johnMamish/milliLearn-boards/README.md

# milliLearn-boards
Dev boards targeting low-power machine learning
