johnMamish/milliLearn-boards/ice40/milliLearn-ice40/milliLearn-ice40.brd

## EAGLE design ice40/milliLearn-ice40/milliLearn-ice40.brd (2020-08-04)

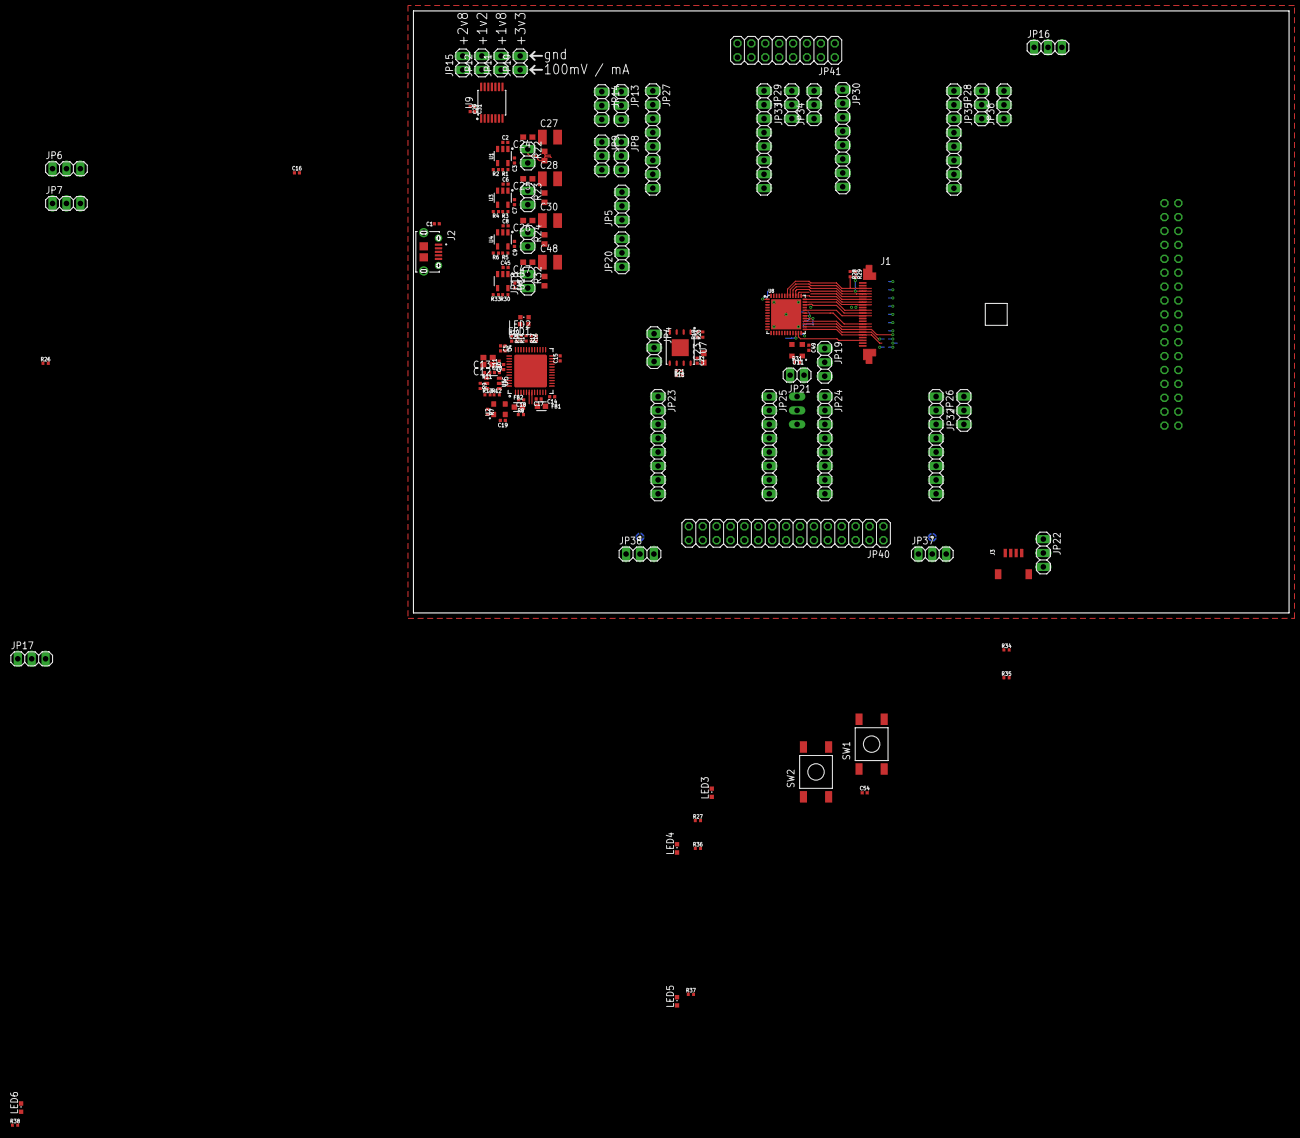
[picture p7: board milliLearn-ice40.brd from above]

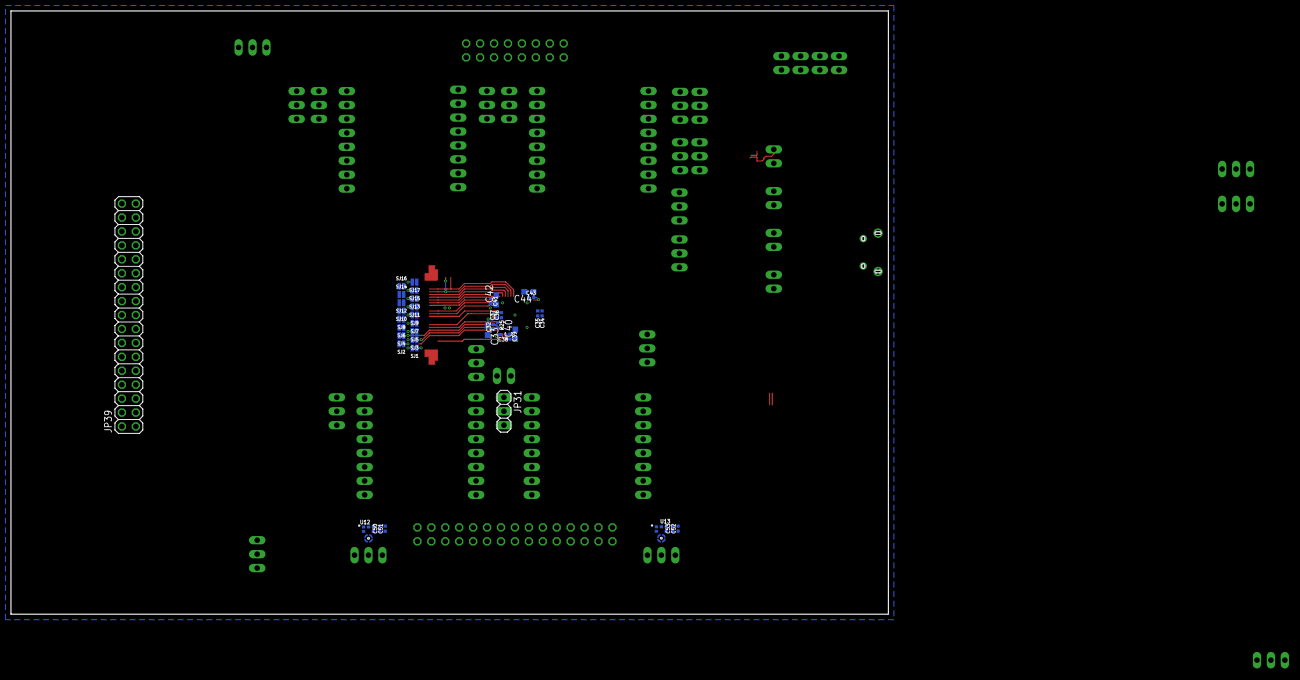
[picture p8: board milliLearn-ice40.brd from below]

Board: 4 copper layers, 160.0 x 110.0 mm, 176 parts (39 on the bottom side), 124 nets.

Parts:
C1: C0402_COMPACT
C2, C3, C6, C7, C8, C9, C29, C34, C36, C45, C46: 1u; C0402_COMPACT
C4, C5, C10, C11, C14, C15, C16, C17, C18, C19, C20, C22, C31, C32, C35, C37, C38, C39, C41, C43, C49, C50, C52, C54: 100n; C0402_COMPACT
C12, C13, C23, C24, C25, C26, C33, C40, C42, C44, C47: 4.7u; C0603
C21: 10n; C0402_COMPACT
C27, C28, C30, C48: 22u; C1210
C51, C53: 220p; C0402_COMPACT
FB1, FB2: BLM18KG601SN1D
J1: SFV24R-2STE1HLF
J2: 10118194-0001LF; AMPHENOL_10118194-0001LF
J3: SM04B-SRSS-TB(LF)(SN)
JP1, JP2, JP3, JP10, JP11, JP12, JP15, JP18, JP21: 1X02
JP4, JP5, JP6, JP7, JP8, JP9, JP13, JP14, JP16, JP17, JP19, JP20, JP22, JP31, JP32, JP33, JP34, JP35, JP36, JP37, JP38: 1X03
JP23, JP24, JP25, JP26, JP27, JP28, JP29, JP30: 1X08
JP39: 2X17
JP40: 2X15
JP41: 2X08
LED1, LED2, LED3, LED4, LED5, LED6: CHIPLED_0603
R1: 75k 1%; R0402_COMPACT
R2, R6: 24k 1%; R0402_COMPACT
R3: 20k 1%; R0402_COMPACT
R4: 16k 1%; R0402_COMPACT
R5, R8, R33: 12k 1%; R0402_COMPACT
R7, R10, R11, R18, R19, R20, R21, R26, R28, R29, R31: 10k; R0402_COMPACT
R9: 2.2k; R0402_COMPACT
R12, R13: DNP; R0402_COMPACT
R14, R15, R27, R36, R37, R38: 1k; R0402_COMPACT
R16, R34, R35: 4.7k; R0402_COMPACT
R17: 12k; R0402_COMPACT
R22, R23, R24, R32: 0.5 1%; R0603
R25: 100; R0402_COMPACT
R30: 30k 1%; R0402_COMPACT
SJ1, SJ2, SJ3, SJ4, SJ5, SJ6, SJ7, SJ8, SJ9, SJ10, SJ11, SJ12, SJ13, SJ14, SJ15, SJ16, SJ17: JUMPER-SMT_2_NC_PASTE_NO-SILK; SMT-JUMPER_2_NC_PASTE_NO-SILK
SW1, SW2: TE_FSMJSMA
U1, U3, U4, U10: AP7366-W5-7
U2, U11: DSC6111CI2A-012.0000
U5: MICROBUILDER_FT232HQ; MICROBUILDER_QFN48_8MM
U6: MICROCHIP_93LC76B; MICROCHIP_SOT23-6
U7: MT25QL128ABA1EW7
U8: ICE40UP5K/3K-SG48
U9: INA4180A4IPWR
U12, U13: SPH0645LM4H-B

Connections:
+1V2: C9.2, JP3.1, JP5.1, JP20.1, R5.1, U4.5
+1V2_METERED: C26.1, C30.1, JP5.3, JP20.3, R24.2, U9.9
+1V8: C7.2, JP2.1, JP9.1, JP14.1, JP16.1, JP34.1, JP36.1, R3.1, U3.5
+1V8_METERED: C25.1, C28.1, JP9.3, JP14.3, JP16.3, JP34.3, JP36.3, R23.2, U9.6
+2V8: C46.2, JP17.1, JP18.1, R30.1, U10.5
+2V8_METERED: C47.1, C48.1, JP17.3, R32.2, U9.13
+3V3: C3.2, C29.2, C31.2, JP1.1, JP4.1, JP6.1, JP7.1, JP8.1, JP13.1, JP19.1, JP22.1, JP31.1, JP32.1, JP33.1, JP35.1, JP37.1, JP38.1, R1.1, R27.1, R36.1, R37.1, R38.1, U1.5, U9.4
+3V3_METERED: C24.1, C27.1, JP4.3, JP6.3, JP7.3, JP8.3, JP13.3, JP19.3, JP22.3, JP31.3, JP32.3, JP33.3, JP35.3, JP37.3, JP38.3, R22.2, U9.2
CONFIG_FLASH_+3V3: C22.2, C23.1, JP4.2, R18.1, R19.1, R20.1, R21.1, U7.8
D+: J2.3, U5.7
D-: J2.2, U5.6
FT232_OSC_12M: U2.P$3, U5.1
FT232_VCCD: C11.2, C13.1, C14.2, C15.2, C16.2, C19.2, C20.2, FB1.1, FB2.1, LED1.A, LED2.A, R7.1, R10.1, R11.1, R12.1, R13.1, U2.P$4, U5.12, U5.24, U5.39, U5.46, U6.6
GND: C1.1, C2.1, C3.1, C4.1, C5.1, C6.1, C7.1, C8.1, C9.1, C10.1, C11.1, C12.2, C13.2, C14.1, C15.1, C16.1, C17.1, C18.1, C19.1, C20.1, C21.1, C22.1, C23.2, C24.2, C25.2, C26.2, C27.2, C28.2, C29.1, C30.2, C31.1, C32.1, C33.2, C34.1, C35.1, C36.1, C37.1, C38.1, C39.1, C40.2, C41.1, C42.2, C43.1, C44.2, C45.1, C46.1, C47.2, C48.2, C49.1, C50.1, C51.1, C52.1, C53.1, C54.1, J1.P$2, J1.P$15, J2.5, J2.S1, J2.S2, J2.S3, J2.S4, J2.S5, J2.S6, J3.P$1, JP10.2, JP11.2, JP12.2, JP15.2, JP21.2, JP23.2, JP23.4, JP23.6, JP23.7, JP23.8, JP24.2, JP24.4, JP24.6, JP24.7, JP24.8, JP25.2, JP25.4, JP25.6, JP25.8, JP26.2, JP26.4, JP26.6, JP26.8, JP27.2, JP27.4, JP27.6, JP27.7, JP27.8, JP28.2, JP28.4, JP28.6, JP28.7, JP28.8, JP29.2, JP29.4, JP29.6, JP29.8, JP30.2, JP30.4, JP30.6, JP30.8, JP39.2, JP39.4, JP39.6, JP39.8, JP39.10, JP39.12, JP39.14, JP39.16, JP39.18, JP39.20, JP39.22, JP39.24, JP39.26, JP39.28, JP39.30, JP39.32, JP39.34, JP40.2, JP40.4, JP40.6, JP40.8, JP40.10, JP40.12, JP40.14, JP40.16, JP40.18, JP40.20, JP40.22, JP40.24, JP40.26, JP40.28, JP40.30, JP41.2, JP41.4, JP41.6, JP41.8, JP41.10, JP41.12, JP41.14, JP41.16, LED6.C, R2.2, R4.2, R6.2, R8.1, R17.2, R33.2, SW1.P$3, SW1.P$4, SW2.P$3, SW2.P$4, U1.2, U2.P$2, U3.2, U4.2, U5.4, U5.9, U5.10, U5.11, U5.22, U5.23, U5.35, U5.36, U5.41, U5.42, U5.47, U5.48, U5.THERMAL, U6.2, U7.4, U7.9, U8.49, U9.11, U10.2, U11.P$2, U12.P$2, U12.P$3@0, U12.P$3@1, U12.P$3@2, U12.P$3@3, U13.P$3@0, U13.P$3@1, U13.P$3@2, U13.P$3@3
HM01B0_+1V8: J1.P$10, JP16.2, R28.1, R29.1
HM01B0_+2V8: J1.P$4, J1.P$11, JP17.2
HM01B0_D0: J1.P$14, SJ9.1, U8.35
HM01B0_D1: J1.P$3, SJ1.1, U8.23
HM01B0_D2: J1.P$9, SJ6.1, U8.31
HM01B0_D3: J1.P$5, SJ2.1, U8.25
HM01B0_D4: J1.P$12, SJ7.1, U8.32
HM01B0_D5: J1.P$20, SJ14.1, U8.40
HM01B0_D6: J1.P$19, SJ13.1, U8.39
HM01B0_D7: J1.P$13, SJ8.1, U8.34
HM01B0_HS: J1.P$16, SJ10.1, U8.36
HM01B0_INT: J1.P$18, LED3.C, SJ12.1, U8.38
HM01B0_MCK: J1.P$8, SJ5.1, U8.28
HM01B0_PCLK: J1.P$17, SJ11.1, U8.37
HM01B0_SCL: J1.P$21, R29.2, SJ15.1, U8.41
HM01B0_SDA: J1.P$22, R28.2, SJ16.1, U8.42
HM01B0_TRIG: J1.P$7, LED5.C, SJ4.1, U8.27
HM01B0_VS: J1.P$6, SJ3.1, U8.26
I2S_WS: JP40.29, U8.21, U12.P$1, U13.P$1
ICE40_+1V2_CORE: C34.2, C35.2, C36.2, C37.2, JP20.2, U8.5, U8.30
ICE40_+1V2_PLL: JP5.2, R25.1
ICE40_CRESETB: C54.2, R26.2, SW1.P$1, SW1.P$2, U5.20, U8.8
ICE40_FLASH_CIPO: JP40.21, JP40.27, U5.15, U7.2, U8.17, U12.P$6, U13.P$6
ICE40_FLASH_COPI: JP40.15, LED4.C, U5.14, U7.5, U8.14
ICE40_FLASH_PS: JP40.19, R19.2, U5.17, U7.1, U8.16
ICE40_FLASH_SCK: JP40.17, R18.2, U5.13, U7.6, U8.15, U12.P$4, U13.P$4
ICE40_GPIO43: LED6.A, R38.2, SJ17.1, SW2.P$1, SW2.P$2, U8.43
ICE40_OSC_12M: JP41.1, U8.20, U11.P$3
ICE40_OSC_VCC: C49.2, JP19.2, R31.1, U11.P$4
ICE40_SPI_VCCIO1: C39.2, C40.1, JP7.2, R26.1, U8.22
ICE40_VCCIO0: C41.2, C42.1, JP8.2, JP9.2, U8.33
ICE40_VCCIO2: C43.2, C44.1, JP13.2, JP14.2, U8.1
ICE40_VCCPLL: C32.2, C33.1, R25.2, U8.29
ICE40_VPP2V5_+3V3: C38.2, JP6.2, U8.24
MEM1_!HOLD: JP25.3, JP26.3, JP40.13, U8.13
MEM1_!WP: JP23.5, JP24.5, JP40.11, U8.12
MEM1_CIPO: JP23.3, JP24.3, JP40.9, U8.11
MEM1_COPI: JP25.7, JP26.7, JP40.25, U8.19
MEM1_PS1: JP23.1, JP40.5, U8.9
MEM1_PS2: JP24.1, JP40.7, U8.10
MEM1_SCK: JP25.5, JP26.5, JP40.23, U8.18
MEM1_VCC1: JP25.1, JP31.2
MEM1_VCC2: JP26.1, JP32.2
MEM2_!WP: JP27.5, JP28.5, JP41.9, U8.48
MEM2_CIPO1: JP27.3, JP41.7, U8.47
MEM2_CIPO2: JP28.3, U8.4
MEM2_COPI1: JP29.7, JP41.11, U8.2
MEM2_COPI2: JP30.7, U8.44
MEM2_PS1: JP27.1, JP41.3, U8.45
MEM2_PS2: JP28.1, JP41.5, U8.46
MEM2_SCK: JP29.5, JP30.5, JP41.13, U8.3
MEM2_VCC1: JP29.1, JP33.2, JP34.2
MEM2_VCC2: JP30.1, JP35.2, JP36.2
MIC1_VCC: C50.2, C51.2, JP37.2, U12.P$5
MIC2_VCC: C52.2, C53.2, JP38.2, U13.P$2, U13.P$5
unnamed: R5.2, R6.1, U4.4
unnamed: R1.2, R2.1, U1.4
unnamed: JP1.2, R22.1, U9.3
unnamed: C18.2, FB2.2, U5.3
unnamed: C17.2, FB1.2, U5.8
unnamed: R3.2, R4.1, U3.4
unnamed: R7.2, U2.P$1
unnamed: R9.1, R11.2, U6.1
unnamed: R8.2, U5.5
unnamed: R9.2, U5.43, U6.3
unnamed: R13.2, U5.45, U6.5
unnamed: R12.2, U5.44, U6.4
unnamed: R14.1, U5.32
unnamed: C21.2, R10.2, U5.34
unnamed: LED1.C, R14.2
unnamed: R16.2, R17.1, U5.31
unnamed: R15.1, U5.33
unnamed: LED2.C, R15.2
unnamed: R20.2, U7.3
unnamed: R21.2, U7.7
unnamed: JP2.2, R23.1, U9.5
unnamed: JP3.2, R24.1, U9.10
unnamed: JP10.1, U9.1
unnamed: JP11.1, U9.7
unnamed: JP12.1, U9.8
unnamed: JP15.1, U9.14
unnamed: R30.2, R33.1, U10.4
unnamed: JP18.2, R32.1, U9.12
unnamed: JP21.1, R31.2, U11.P$1
unnamed: LED3.A, R27.2
unnamed: LED4.A, R36.2
unnamed: LED5.A, R37.2
unnamed: JP39.1, SJ1.2
unnamed: JP39.3, SJ2.2
unnamed: JP39.5, SJ3.2
unnamed: JP39.7, SJ4.2
unnamed: JP39.9, SJ5.2
unnamed: JP39.11, SJ6.2
unnamed: JP39.13, SJ7.2
unnamed: JP39.15, SJ8.2
unnamed: JP39.17, SJ9.2
unnamed: JP39.19, SJ10.2
unnamed: JP39.21, SJ11.2
unnamed: JP39.23, SJ12.2
unnamed: JP39.25, SJ13.2
unnamed: JP39.27, SJ14.2
unnamed: JP39.29, SJ15.2
unnamed: JP39.31, SJ16.2
unnamed: JP39.33, SJ17.2
QWIIC_+3V3: J3.P$2, JP22.2, R34.1, R35.1
QWIIC_SCL: J3.P$4, JP40.3, R35.2, U8.7
QWIIC_SDA: J3.P$3, JP40.1, R34.2, U8.6
VCCA: C4.2, U5.37
VCCCORE: C5.2, U5.38
VUSB: C1.2, C2.2, C6.2, C8.2, C10.2, C12.1, C45.2, J2.1, R16.1, U1.1, U1.3, U3.1, U3.3, U4.1, U4.3, U5.40, U10.1, U10.3
