johnMamish/milliLearn-boards/(commit log)

2020-08-03 iCE40 board wip
    [milliLearn-ice40.brd, milliLearn-ice40.sch]
2020-08-04 pcb-ng board wip
    [milliLearn-ice40-pcbng.brd, milliLearn-ice40-pcbng.sch, milliLearn-ice40.brd]
2020-08-05 routing for pcbng variant wip
    [milliLearn-ice40-pcbng.brd, milliLearn-ice40-pcbng.sch]
2020-08-05 first pass of routing done
    [milliLearn-ice40-pcbng.brd, milliLearn-ice40-pcbng.sch]
2020-08-06 fix hm01b0 connector footprint
    [milliLearn-ice40-pcbng.brd, milliLearn-ice40-pcbng.sch]
